Kozucjusz/TEF6686_MODULE/schematics/TEF6686_MODULE_top_pcb.pdf

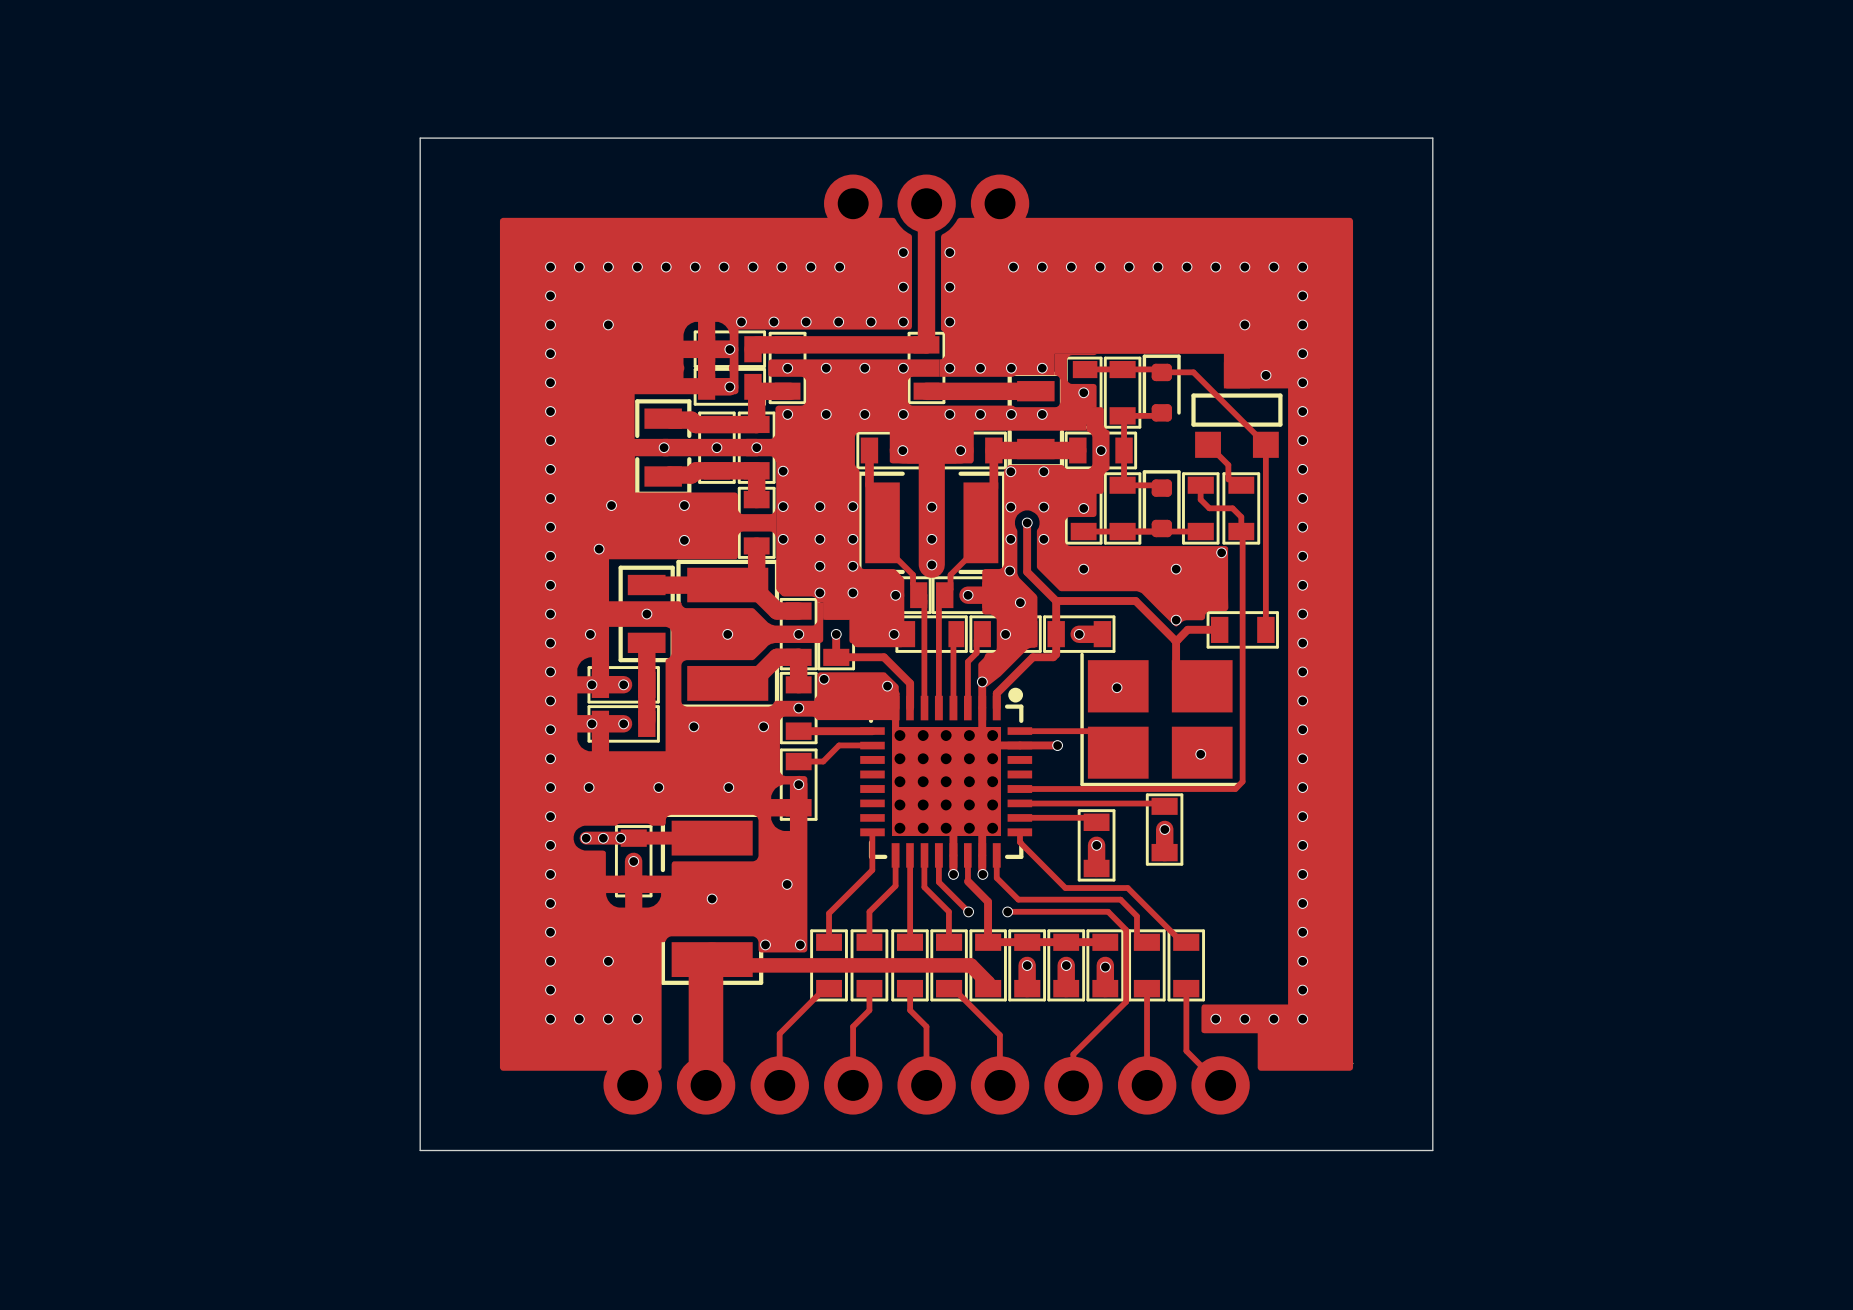
[picture p5: page 1]
