Kozucjusz/TEF6686_MODULE/schematics/TEF6686_MODULE_bottom_pcb.pdf

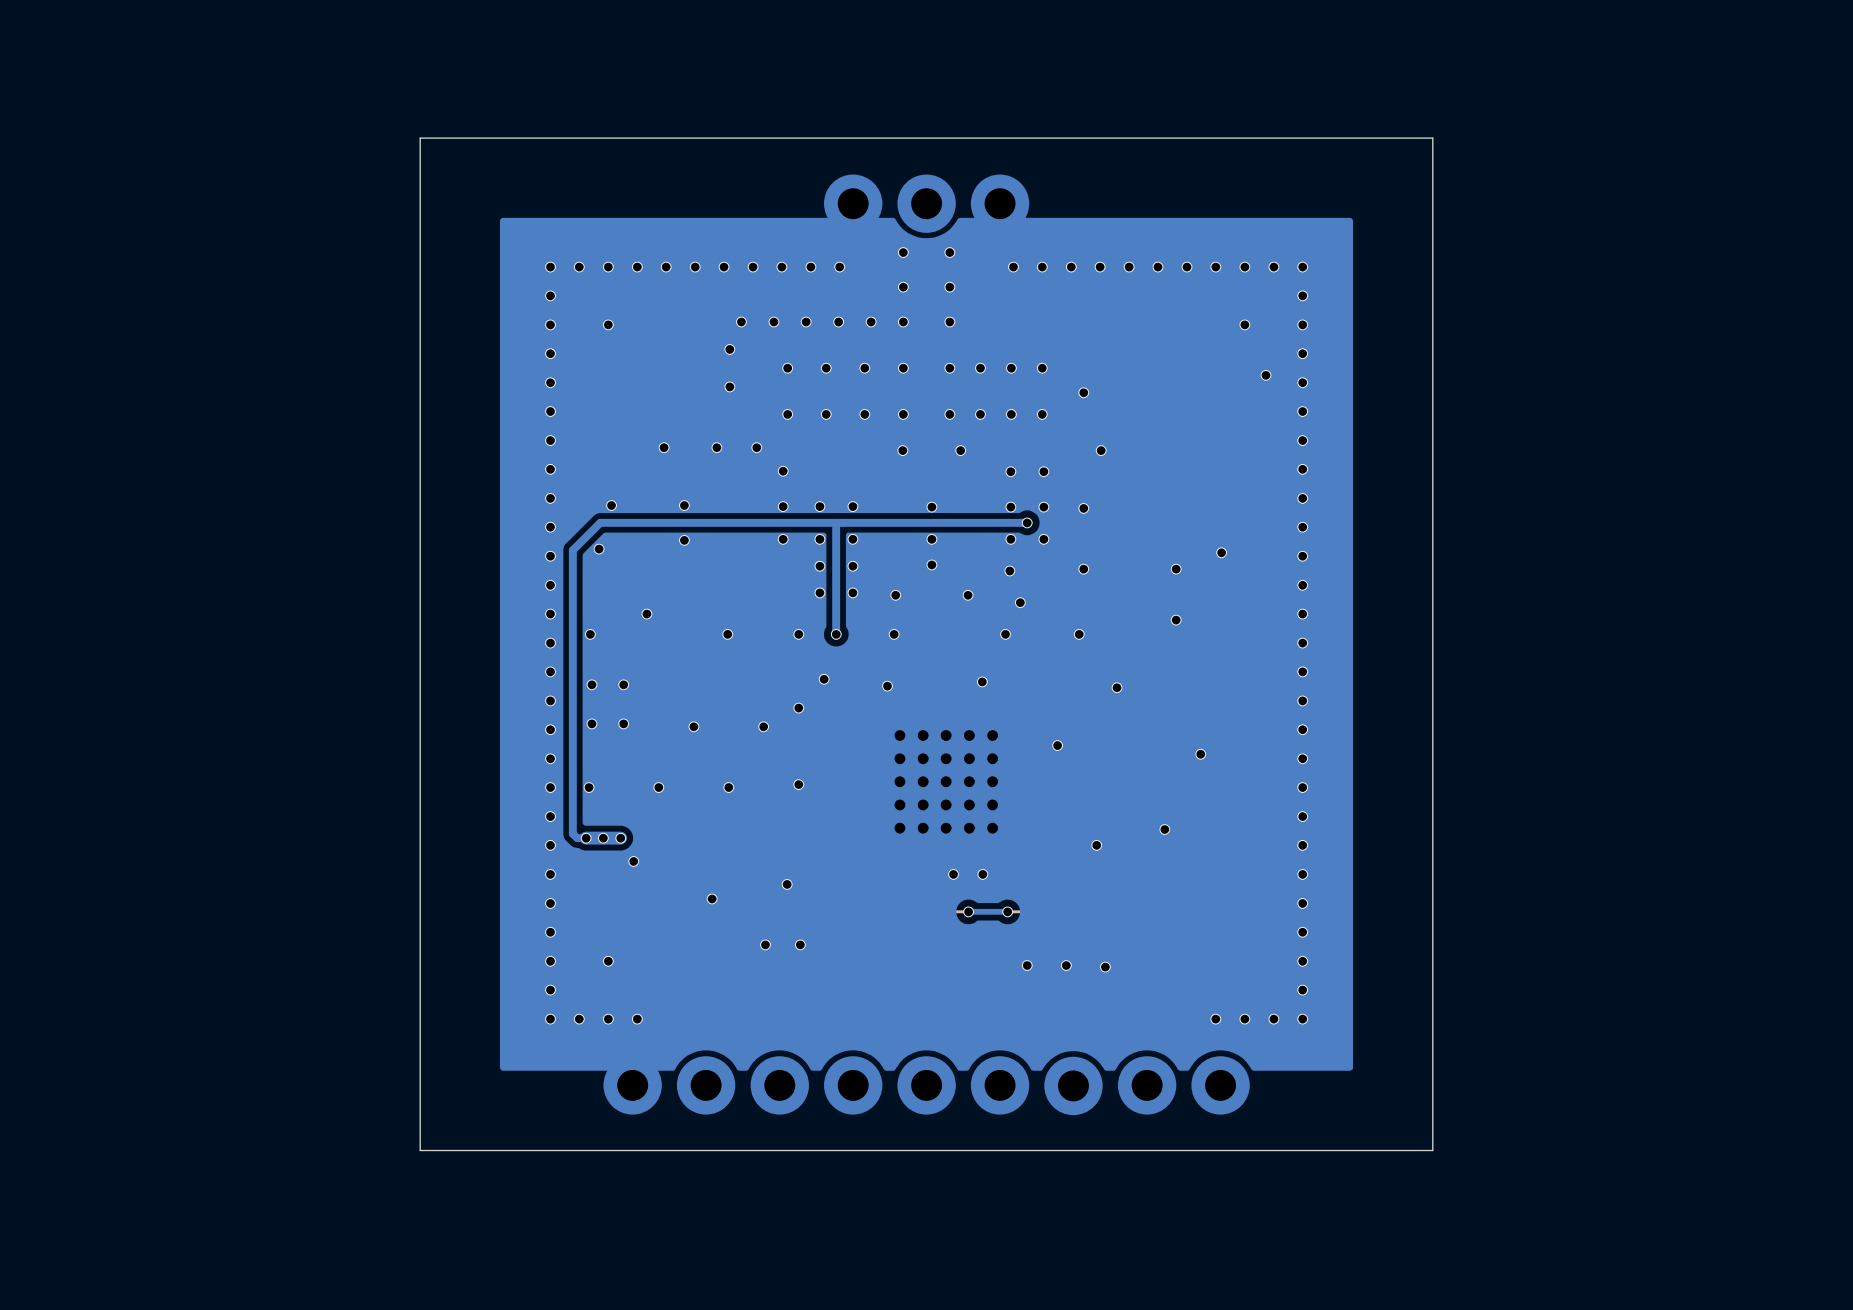
[picture p6: page 1]
