Kozucjusz/TEF6686_MODULE/schematics/TEF6686_MODULE_sch.pdf

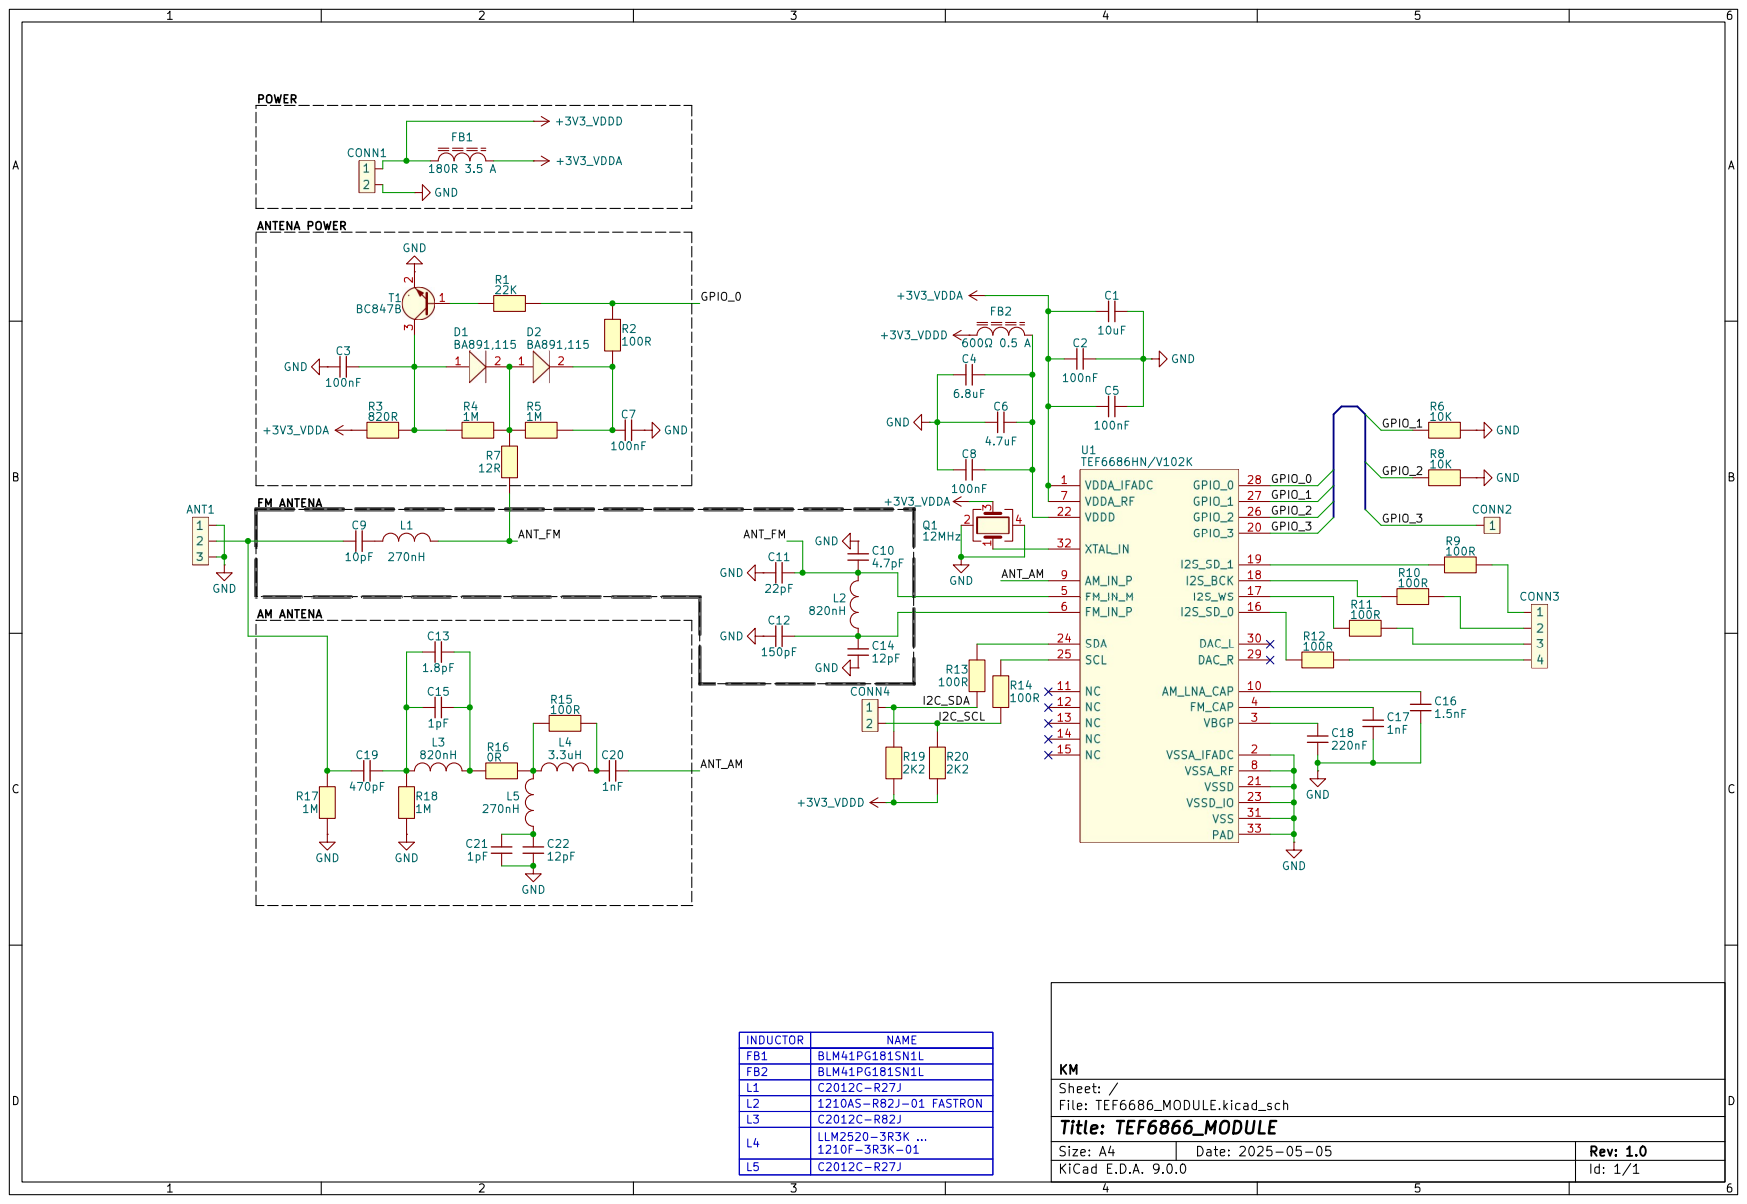
[picture p7: page 1]
