Kozucjusz/TEF6686_MODULE/Inc/TEF6686.h

/*
 * TEF6686.h
 *
 *  Created on: Dec 12, 2024
 *      Author: kmurawski
 */

#ifndef __TEF6686_H__
#define __TEF6686_H__

#ifdef __cplusplus
extern "C" {
#endif

//#include <stdint.h>
//#include "i2c.h"
#include "main.h"



void TEF6686_GetCommand(I2C_HandleTypeDef *hi2c, uint8_t module, uint8_t cmd, uint16_t *response, uint8_t responseLength);
void TEF6686_SetCommand(I2C_HandleTypeDef *hi2c, uint8_t module, uint8_t cmd, uint16_t *params, uint8_t paramsCount);

void TEF6686_WriteInitData(I2C_HandleTypeDef *hi2c1, const uint8_t *data);
void TEF6686_Appl_Set_OperationMode(uint8_t mode);
void TEF6686_Init(I2C_HandleTypeDef *hi2c1);
void TEF6686_Tune_To(uint8_t module, uint16_t freq);
void TEF6686_Audio_Set_Mute(uint8_t mute);

static const uint8_t INIT_DATA[]  = {
	0x03,0x1C,0x00,0x00,  // Clear Required Initialization Control
	0x03,0x1C,0x00,0x74,  // Set Required Initialization Control
	0x19,0x1B,0xF0,0x00,0x38,0x3B,0xD0,0x80,0xF0,0x00,0x38,0x43,0xD0,0x80,0x43,0xB2,0x38,0x46,0xD0,0x80,0xF0,0x00,0x70,0x00,0xC2,0xF7,
	0x19,0x1B,0xF0,0x00,0x38,0x77,0xD0,0x80,0xF0,0x00,0x38,0x7B,0xDF,0x80,0x80,0xFC,0x39,0x0E,0xD0,0x80,0xC2,0x38,0x20,0x11,0x40,0xB7,
	0x19,0x1B,0x9F,0xA7,0x39,0x13,0xD2,0x80,0x9F,0xA7,0x39,0x1D,0xD2,0x80,0xF0,0x00,0x39,0x24,0xD0,0x80,0xF0,0x00,0x39,0x27,0xD0,0x80,
	0x19,0x1B,0x90,0x41,0x39,0x49,0xDD,0x80,0xF0,0x00,0x3A,0x25,0xD0,0x80,0xF0,0x00,0x39,0x4D,0xD0,0x80,0xF0,0x00,0x3A,0x27,0xD0,0x80,
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
	0x05,0x30,0x0A,0x01,0xFF,0x38,	//SET VOLUME
	0x07,0x30,0x0D,0x01,0x00,0x21,0x00,0x04,
	0x0D,0x30,0x16,0x01,0x00,0x21,0x00,0x02,0x00,0x20,0x01,0x00,0x12,0xC0,
	0x00
};



#ifdef __cplusplus
}
#endif

#endif /* __TEF6686_H__ */
